ElectronicCats/MICS4514-Croquette/README.md

# Electronic Cats Croquette MICS4514

Electronic Cats invests time and resources providing this open source design, please support Electronic Cats and open-source hardware by purchasing products from Electronic Cats!

Designed by Electronic Cats.

Firmware released under an GNU AGPL v3.0 license. See the LICENSE file for more information.

Hardware released under an CERN Open Hardware Licence v1.2. See the LICENSE_HARDWARE file for more information.

Electronic Cats is a registered trademark, please do not use if you sell these PCBs.

28 August 2019
