ElectronicCats/MICS4514-Croquette/hardware/3D/MICS-4514.step

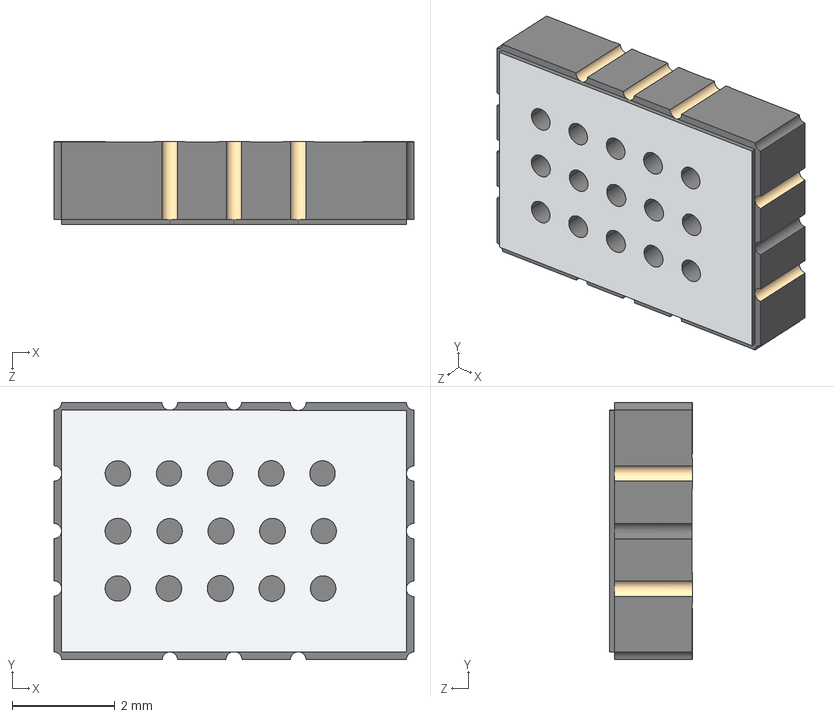
[picture p1: CAD file, 2020-04-24]
hardware/3D/MICS-4514.step
7.00 x 5.00 x 1.61 mm
