ElectronicCats/MICS4514-Croquette/form calibration sensor.xlsx

Sheet: CO
CO
Rs/R0 | ppm
3.5 | 1
1.8 | 2
1 | 4.5
0.7 | 7
0.5 | 10
0.2 | 30
0.1 | 70
0.07 | 100
0.04 | 200
0.03 | 300
0.02 | 450
0.01 | 1000
 |  | DATASHEET 2: | https://www.sgxsensortech.com/content/uploads/2014/08/0278_Datasheet-MiCS-4514.pdf
 |  | Documento referencia ppm | https://www.wcf.com/hoja-de-informaci%C3%B3n-sobre-el-mon%C3%B3xido-de-carbono-co

Sheet: NO2
NO2
Rs/R0 | ppm
0.65 | 0.01
0.18 | 0.03
0.25 | 0.04
0.3 | 0.05
0.5 | 0.08
0.6 | 0.1
2 | 0.3
4 | 0.6
5 | 0.8
6.3 | 1
13 | 2
20 | 3
25 | 4
32 | 5
40 | 6
 |  | https://www.sgxsensortech.com/content/uploads/2014/08/0278_Datasheet-MiCS-4514.pdf
