ElectronicCats/MICS4514-Croquette/(commit log)

2019-02-22 example read sensor
2019-02-22 add schematics and pcb
    [breakboard_MICS4514.kicad_pcb, breakboard_MICS4514.sch]
2019-02-22 add logos
    [breakboard_MICS4514.kicad_pcb]
2019-03-26 add calculus form sensors
    [form calibration sensor.xlsx]
2019-03-26 ppm CO and NO2
    [form calibration sensor.xlsx]
2019-03-28 change equations and datasheet
    [form calibration sensor.xlsx]
2019-06-10 shape of edge cuts
    [breakboard_MICS4514.kicad_pcb, breakboard_MICS4514.sch, form calibration sensor.xlsx]
2019-12-20 right measures
    [breakboard_MICS4514.kicad_pcb]
2019-12-21 arrangement componets
    [breakboard_MICS4514.kicad_pcb]
2020-01-22 Change place componets
    [breakboard_MICS4514.kicad_pcb]
2020-01-23 change margin pcb
    [breakboard_MICS4514.kicad_pcb]
2020-01-23 Routeo mics and res
    [breakboard_MICS4514.kicad_pcb]
2020-01-24 Routeo and logos
    [breakboard_MICS4514.kicad_pcb]
2020-01-30 fix label extra
    [breakboard_MICS4514.kicad_pcb]
2020-04-24 Add 3D fix labels add Croquette logo
    [MICS-4514.step, breakboard_MICS4514.kicad_pcb]
2020-04-24 Add voltage pins for opamp, add decoupling caps, new component placement
    [breakboard_MICS4514.kicad_pcb, breakboard_MICS4514.sch]
2020-04-24 fix label
    [breakboard_MICS4514.kicad_pcb]
